jrrrr26/FPGA-basys3-robotic_arm/data/README.md

# 数据目录

```text
data/
├── README.md
└── samples/
    ├── mpu_axes_sample.csv
    ├── telemetry_template.csv
    └── README.md
```

数据说明见 [report/data-card.md](../report/data-card.md)。
