jrrrr26/FPGA-basys3-robotic_arm/report/figures/README.md

# 报告插图

| 文件名 | 内容 |
| --- | --- |
| `system-block-diagram.png` | 图 3-1 系统功能框图，展示传感器、FPGA 处理模块、执行器、UART 和独立舵机电源之间的连接关系 |

该图已插入 `design-report.md`、`design-report.docx` 和 `design-report.pdf` 的 3.3 节。
