jrrrr26/FPGA-basys3-robotic_arm/board/photos/README.md

# 实板照片说明

本目录保存最终系统的实板照片和装配细节。

## 文件清单

| 文件名 | 拍摄内容 |
| --- | --- |
| `board-overview.jpg` | Basys 3、Pmod AD1、MyoWare 和 GY-521 的整体连接 |
| `electrode-mount1.jpg` | 肌电电极的佩戴位置 |
| `electrode-mount2.jpg` | 弯曲传感器的佩戴位置 |
| `sensor-mount.jpg` | MPU6050 的安装位置和 PCB 方向 |
| `arm-overview.jpg` | 三路舵机和机械臂整体结构 |
