jrrrr26/FPGA-basys3-robotic_arm/report/ai-collaboration-log.md

# 大模型协作记录

本记录选取“编写Basys3 Vivado仿真”开发过程中的关键交互，说明提示词、模型建议、人工修改和验证结果。以下内容只记录实际发生过的工作。

## 记录 1：确定最终控制方案

- 日期：2026-10-31
- 任务：确定弯曲传感器和底座舵机的控制逻辑。
- 用户输入摘要：

```text
1. 舵机都是180度的
2. 我希望第一种
3. 行
4. 停止
5. 小的时候往里转也就是逆时针转
6. 保持
```

- 模型建议：
  - 使用绝对阈值区分高值、低值和中间区。
  - 加入滞回，避免阈值附近抖动。
  - 高值向 160°、低值向 20° 点动。
  - 中间区和限位停止 PWM。
  - 启动时在第一次有效方向出现前不输出 PWM。
- 人工修改：
  - 根据机械结构确认 20°～160° 安全范围。
  - 确认“保持”为保持最后指令角度，不回中位。
- 验证：
  - `TB_FLEX_DIRECTION_CONTROLLER: PASS`
  - 覆盖启动停止、点动、死区、上下限。

## 记录 2：MPU6050 三轴诊断

- 日期：2026-11-01
- 任务：解决底座被其他动作误触发，确认应使用哪个陀螺仪轴。
- 用户输入摘要：

```text
OK, 现在来解决加速度传感器的问题，重新给我说一下
```

以及：

```text
弯曲传感器分压回路使用 12 kΩ 电阻
三轴传感器诊断这个细说一下
```

- 模型建议：
  - 区分加速度计和陀螺仪的作用。
  - 读取 `0x3B`～`0x48` 的加速度、温度和陀螺仪数据。
  - 通过固定模块并分别执行手腕转动、平移和翻转，比较 GX/GY/GZ。
  - 不使用三轴角速度矢量和，避免任何方向晃动都驱动底座。
- 人工修改：
  - 实际完成 MPU6050 固定、接线检查、动作采集。
  - 根据实测结果选择 GY 轴。
  - 增加 `SW0` 方向取反。
- 验证：
  - `mpu_axes_sample.csv` 记录了 200 行真实六轴数据。
  - 最终程序读取 GY 轴并通过低通和零偏校准。

## 记录 3：底座完全不转

- 日期：2026-11-01
- 任务：修复底座“完全不转”的问题。
- 用户输入摘要：

```text
不是现在底盘都不动了怎么回事，上一版速度稍微有一点点快导致没法停这一版完全不转了
```

- 模型分析：
  - `confirm_count` 达到 `CONFIRM_SAMPLES` 后不再增加。
  - 原判断使用 `confirm_count == CONFIRM_SAMPLES - 1`。
  - 条件只在一个样本周期成立，导致目标角只改变一次。
- 代码修改：

```verilog
(same_direction && confirm_count >= CONFIRM_SAMPLES - 1);
```

- 测试修改：
  - 增加超过确认窗口后仍持续运动的目标角检查。
- 验证：

```text
PASS confirmation and positive motion target=91
PASS sustained motion target=96
PASS deadband freezes target=96
PASS negative motion target=95
TB_GYRO_BASE_CONTROLLER: PASS
```

## 记录 4：最终集成与构建

- 日期：2026-11-01
- 任务：完成三传感器、三舵机最终集成并验证。
- 模型建议：
  - 使用 `angle_slew` 平滑机械手和底座角度。
  - 弯曲控制到达中间区或限位后关闭 PWM。
  - 保留 18 字节 UART 遥测。
  - 使用自包含脚本重建工程并核对资源、时序和 DRC。
- 人工修改：
  - 完成实板接线和机械结构联调。
  - 确认三路执行器动作。
- 验证：
  - 三组 Testbench 全部 PASS。
  - 综合、实现：0 error。
  - WNS `+1.048 ns`，WHS `+0.065 ns`。
  - DRC：0 error。
- bitstream 已生成并保存在 `board/`。

## AI 使用声明

- AI 输出由项目成员检查后使用。
- 涉及传感器阈值、舵机方向、接线和时序的修改均经过仿真或实板确认。
- 文档中的测试结果来自 Vivado 输出、CSV 记录或项目组实板联调，不是 AI 自动生成的虚构数据。
