jrrrr26/FPGA-basys3-robotic_arm/report/data-card.md

# 数据卡

## 1. 数据概述

| 字段 | 内容 |
| --- | --- |
| 数据名称 | Basys 3 机械臂联调数据 |
| 采集日期 | 2026-10-31 至 2026-11-01 |
| 数据来源 | 项目组自测 |
| 设备 | Basys 3、Pmod AD1、MyoWare 2.0、GY-521、180° 舵机 |
| 串口 | 115200 8N1，18 字节帧 |
| 用途 | 验证轴选择、阈值、遥测和系统联调 |

## 2. 样本文件

| 文件 | 内容 | 行数 |
| --- | --- | ---: |
| `data/samples/mpu_axes_sample.csv` | AX/AY/AZ、GX/GY/GZ 原始值 | 200 |

## 3. 字段说明

### MPU6050 样本

- `ax/ay/az`：加速度计原始值，默认量程 ±2 g。
- `gx/gy/gz`：陀螺仪原始值，默认量程 ±250 °/s。
- `data_seen`：至少完成过一次有效 I2C 读取。
- `i2c_error`：I2C ACK 异常。
