jrrrr26/FPGA-basys3-robotic_arm/data/samples/README.md

# 样本说明

## mpu_axes_sample.csv

MPU6050 六轴调试数据前 200 行，用于确认 AX/AY/AZ 和 GX/GY/GZ 的响应方向。默认量程：

```text
陀螺仪：±250 °/s，131 LSB/(°/s)
加速度计：±2 g，16384 LSB/g
```

## telemetry_template.csv

空表头模板，用于采集新的最终系统数据。
