jrrrr26/FPGA-basys3-robotic_arm/report/demo-links.md

# 演示材料

完整功能演示：

- Bilibili：[基于 Basys 3 的肌电、弯曲与陀螺仪机械臂控制系统](https://www.bilibili.com/video/BV1iu4K6yEWw)

项目仓库：

- GitHub：[FPGA-basys3-robotic_arm](https://github.com/jrrrr26/FPGA-basys3-robotic_arm)
