jrrrr26/FPGA-basys3-robotic_arm/board/photos/arm-overview.jpg

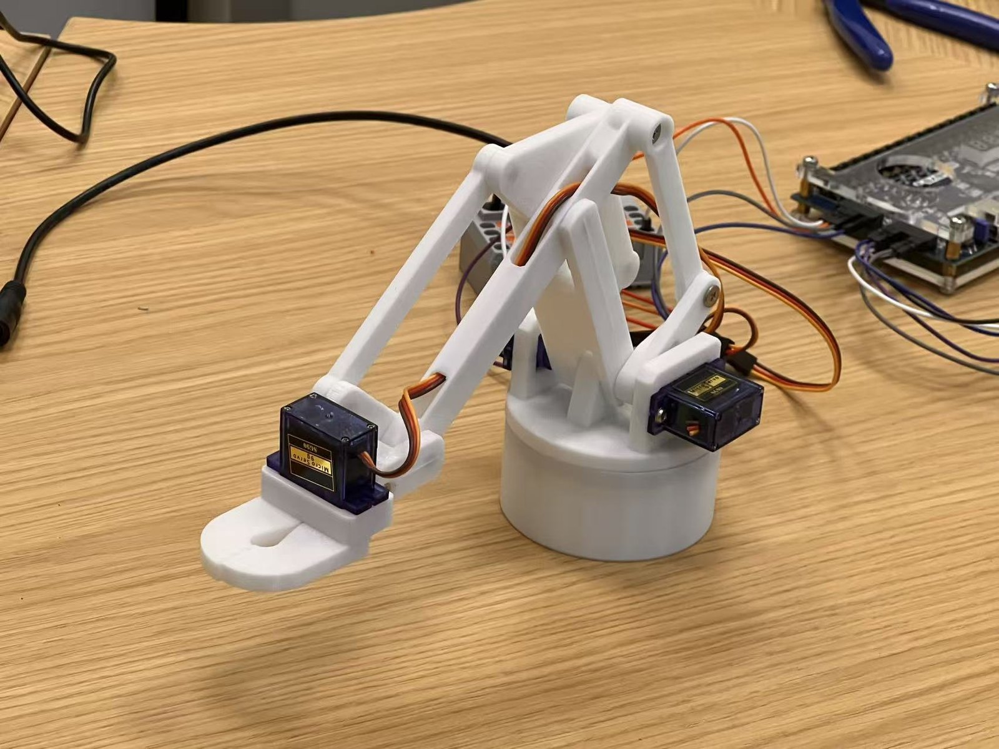
board/photos/arm-overview.jpg
