jrrrr26/FPGA-basys3-robotic_arm/board/photos/board-overview.jpg

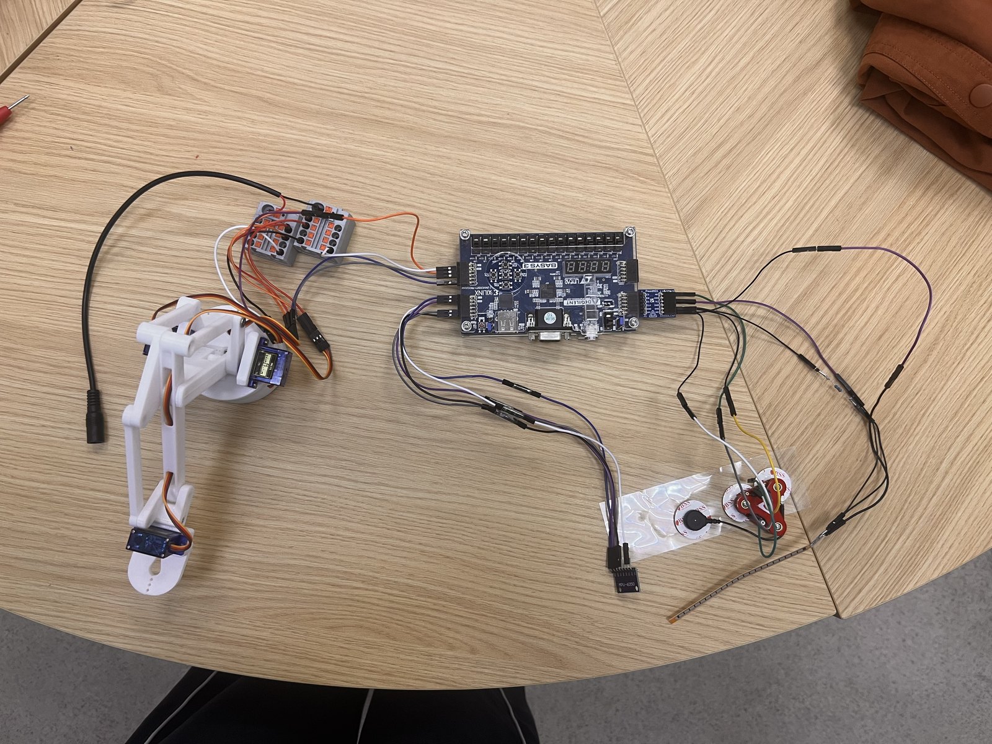
board/photos/board-overview.jpg
