jrrrr26/FPGA-basys3-robotic_arm/board/photos/electrode-mount1.jpg

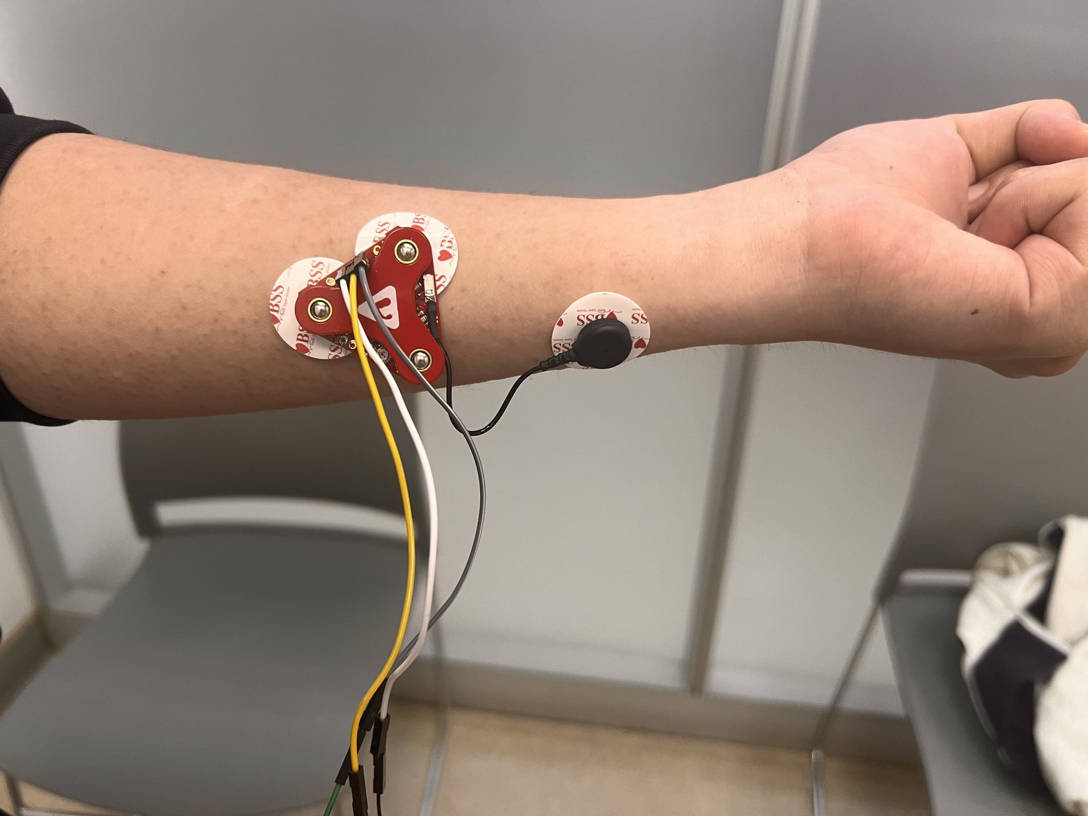
board/photos/electrode-mount1.jpg
