jrrrr26/FPGA-basys3-robotic_arm/board/photos/sensor-mount.jpg

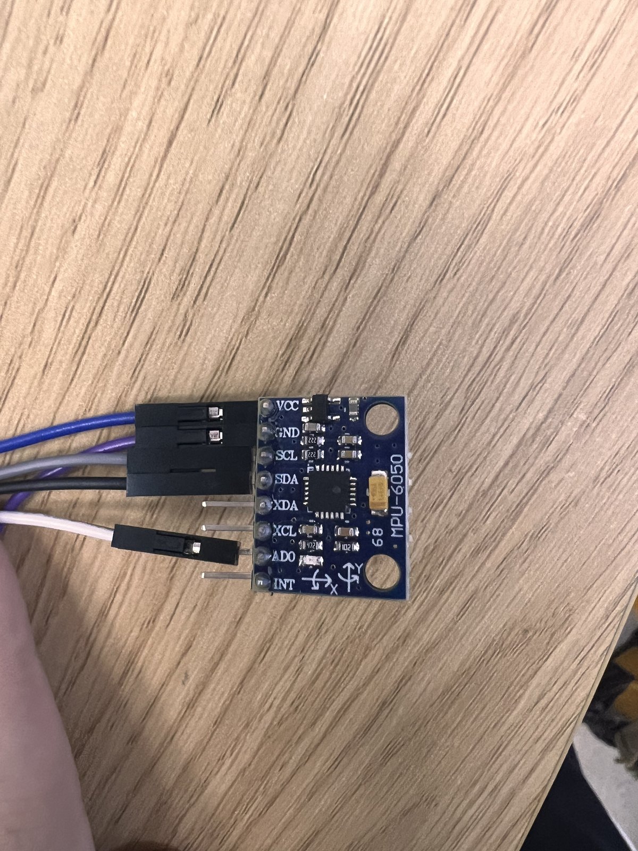
board/photos/sensor-mount.jpg
