jrrrr26/FPGA-basys3-robotic_arm/board/measurements/README.md

# 板级测试记录

- `board-validation.csv`：最终板级测试表。
- `quantitative-results.csv`：重复次数、串口统计和连续运行的量化记录模板。
- `screenshots/`：用于保存串口、波形、PWM 和 Vivado 报告截图。

测量步骤见 [../../report/board-test-method.md](../../report/board-test-method.md)。
