jrrrr26/FPGA-basys3-robotic_arm/report/test-plan.md

# 测试计划

## 1. 测试目标

验证三路传感器、FPGA 处理和三路舵机组成的完整控制链，包括：

- 肌电采集、基线校准和机械手开合。
- 弯曲传感器阈值、滞回、点动和限位停止。
- MPU6050 I2C 通信、GY 轴选择、方向确认和底座控制。
- UART 遥测、LED 状态和七段数码管。
- Vivado 仿真、综合、实现、时序和 DRC。

## 2. 环境

| 项目 | 配置 |
| --- | --- |
| 开发板 | Digilent Basys 3 |
| FPGA | XC7A35T-1CPG236C |
| Vivado | 2025.1 |
| 肌电前端 | MyoWare 2.0 ENV |
| ADC | Pmod AD1 |
| 姿态传感器 | GY-521 / MPU6050 |
| 舵机 | 3 个 180° 位置舵机 |
| 串口 | 115200 8N1 |

## 3. 仿真测试

| 编号 | 内容 | 通过标准 | 状态 |
| --- | --- | --- | --- |
| SIM-01 | 最终系统集成 | `TB_BASYS3_ARM_FINAL_TOP: PASS` | PASS |
| SIM-02 | 弯曲方向控制 | 启动停止、点动、死区、上下限全部 PASS | PASS |
| SIM-03 | 陀螺仪底座控制 | 确认、持续运动、死区冻结、反向运动全部 PASS | PASS |

## 4. 板级功能测试

| 编号 | 内容 | 通过标准 | 状态 |
| --- | --- | --- | --- |
| HW-01 | 上电复位 | LED0 心跳，无异常舵机动作 | 已完成 |
| HW-02 | 自动校准 | 约 1.5 秒后 LED1 点亮、LED3 熄灭 | 已完成 |
| HW-03 | 肌电机械手 | 放松张开，紧绷闭合，松开后返回张开 | 已完成 |
| HW-04 | 弯曲前臂 | 高值向 160° 点动，低值向 20° 点动，中间停止 | 已完成 |
| HW-05 | 陀螺仪底座 | 手腕转动驱动底座，停止后冻结角度 | 已完成 |
| HW-06 | 方向切换 | SW0 改变 GY 控制方向 | 已完成 |
| HW-07 | 按键重校准 | btnU 可重新校准肌电和陀螺仪 | 已完成 |
| HW-08 | UART 遥测 | 18 字节帧校验正确，字段随时间更新 | 已完成 |
| HW-09 | 电源安全 | 三个舵机使用独立 5 V，地与开发板共地 | 已完成 |

## 5. 构建验证

| 检查 | 通过标准 | 状态 |
| --- | --- | --- |
| 综合 | 0 error | PASS |
| 实现 | 0 error | PASS |
| 时序 | WNS 大于 0，所有约束满足 | PASS |
| DRC | 0 error | PASS |
| bitstream | 文件生成且 SHA256 固定 | PASS |

## 6. 数据记录

- 统一保存为 CSV。
- 文件名包含日期和用途。

测试记录和结果见 [test-report.md](test-report.md)。
