jrrrr26/FPGA-basys3-robotic_arm/board/measurements/screenshots/uart-terminal.png

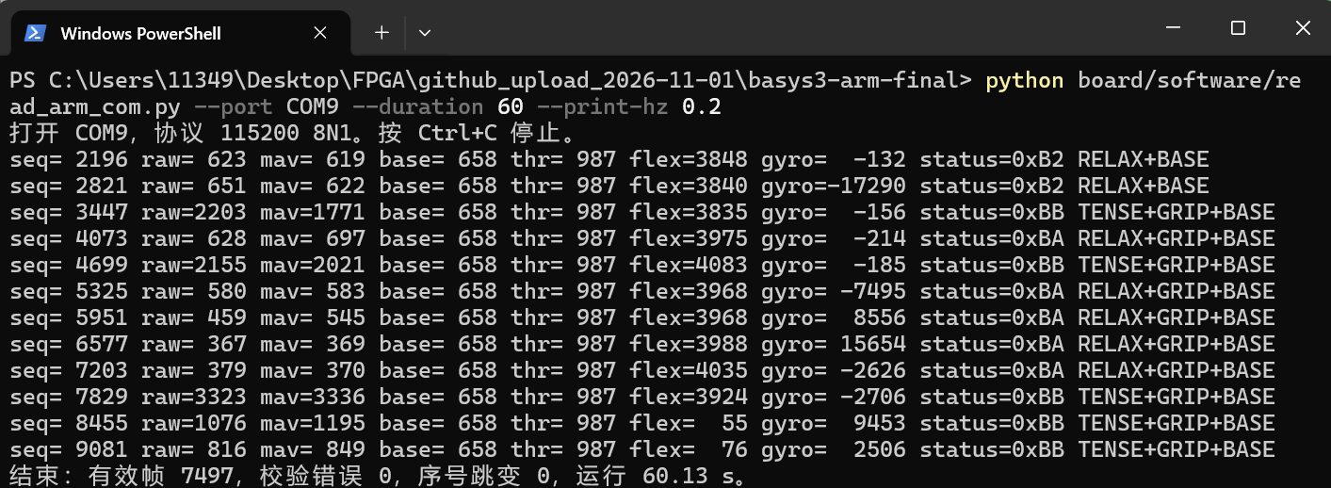
board/measurements/screenshots/uart-terminal.png
