jrrrr26/FPGA-basys3-robotic_arm/board/measurements/screenshots/vivado-simulation.png

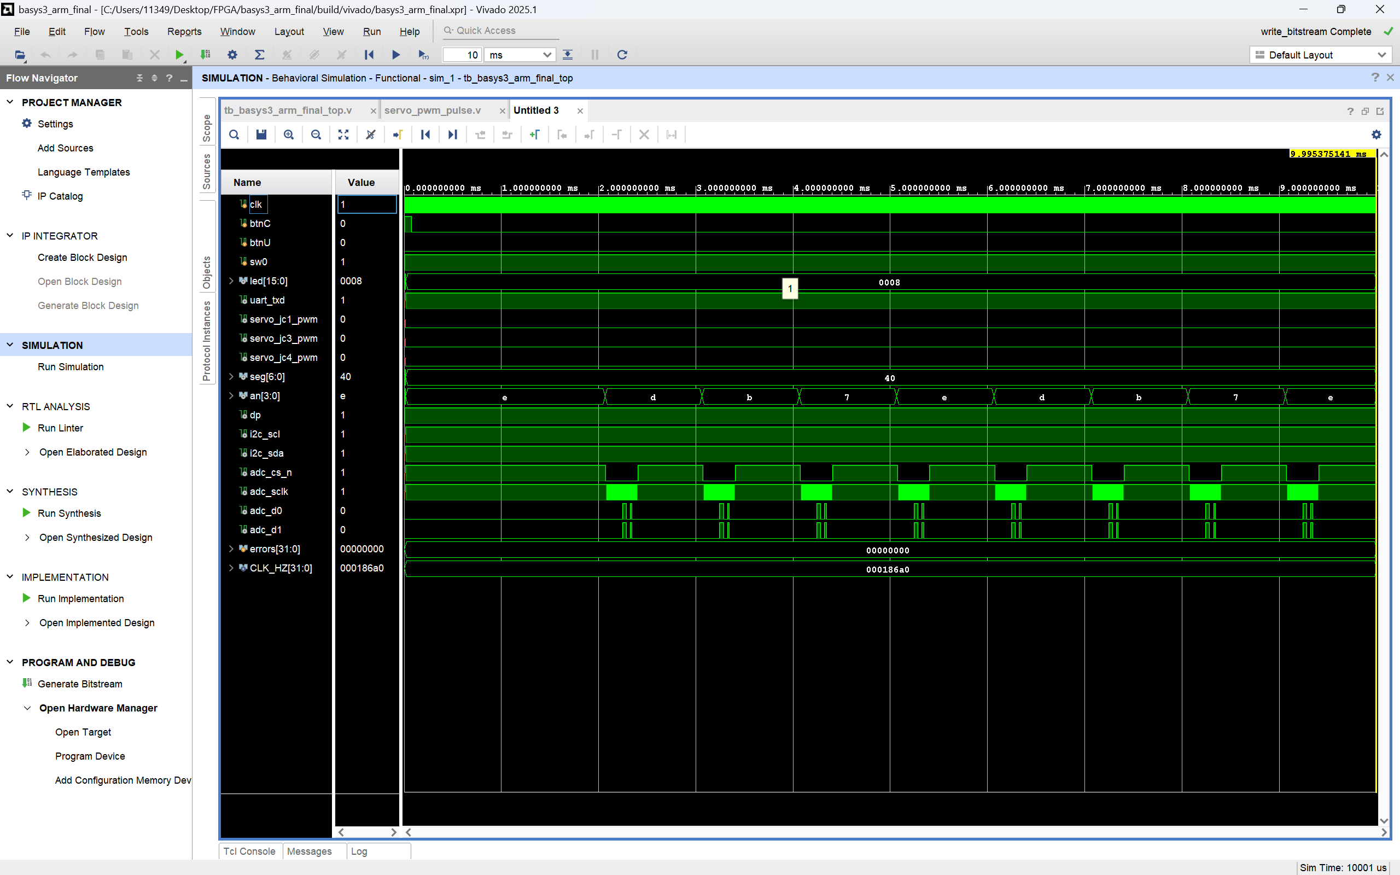
board/measurements/screenshots/vivado-simulation.png
