jrrrr26/FPGA-basys3-robotic_arm/board/measurements/screenshots/vivado-utilization2.png

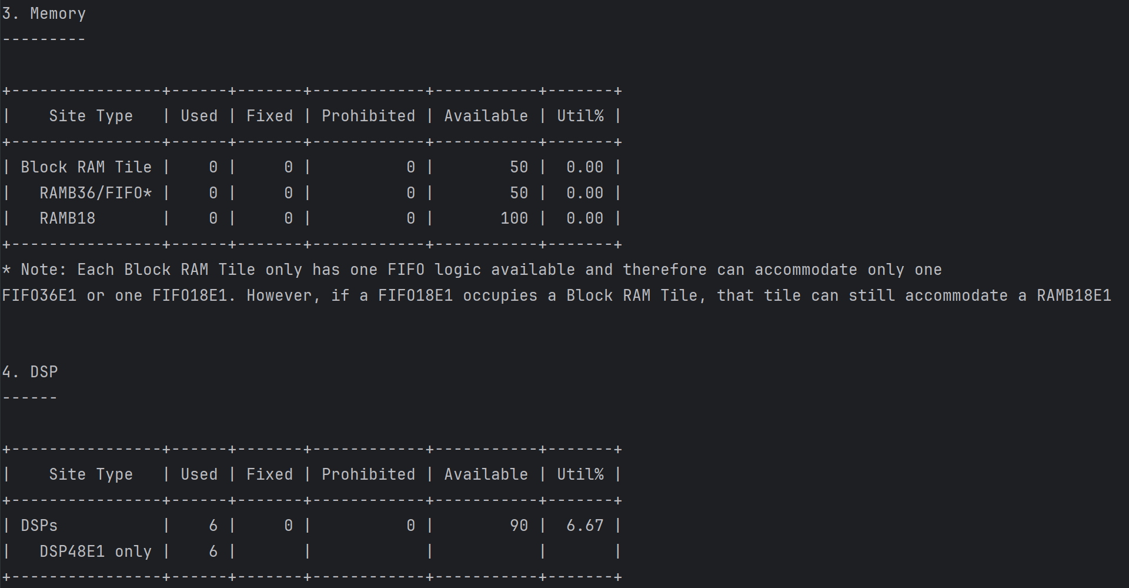
board/measurements/screenshots/vivado-utilization2.png
